jfrverdasca/cpu_ram_gauge/(commit log)

2026-10-06 Notes: lighting colours and salvaged LEDs
2026-10-06 Notes: all lighting LEDs on 150 ohm for now
2026-10-06 Notes: bill of materials as tables
2026-10-06 Notes: complete bill of materials
2026-10-06 Add wiring diagram
2026-10-08 Notes: current CPU cost and RTC summer time
2026-10-08 Add the DS3231 clock and mount the driver chip side up on the perfboard
    With no data the needle shows the minutes and the LCD the time and date.
    gauge.py keeps the clock set; summer time follows the EU rule. The parked
    position moves to the RTC's alarm registers to spare the EEPROM.
2026-10-08 Drop stale LCD text from the queue, end a cut line before parking
2026-10-09 Add photos of the prototype to the README
2026-10-09 Wait 60 ms after the last stop before the needle starts again
    A target falling ~5 steps every 50 ms (the CPU dropping after a heavy
    Spotlight search) made the motor stop and restart while the rotor was
    still ringing, losing dozens of steps going down. The wait now counts
    from the last stop instead of a fixed 20 ms delay() on each start, and
    doesn't block serial or the LCD.
    [gauge.ino, gauge.py]
2026-10-09 Track the HOME_PHASE recalibration for the new motor
    The note pointed to to-do 6, which is already done; give the
    recalibration its own to-do. Also say that homing uses the same settle
    wait as any other move.
2026-10-09 Open the serial port exclusively
    macOS and Linux let a second program open the port, and the Arduino then
    gets two streams of readings: during the bench tests a test script and
    gauge.py both wrote, and the needle swung between their values. A second
    gauge.py now fails to lock the port and retries. The lock is advisory, so
    programs that don't ask for it can still open the port.
    [gauge.py]
2026-10-10 Show the app behind the needle on the LCD while it's high
    The LCD only named the app using the most of the metric the needle
    wasn't showing, so with the needle high there was no way to tell what
    was driving it. Row 1 now swaps uptime and network for that app and its
    own share once the needle's metric passes 60%, back below 50%. The share
    is capped at the total: summed RSS counts shared pages once per process,
    and the app scan is up to 5 s old.
    [gauge.py]
2026-10-10 Scan the top apps every second while CPU or RAM is high
    Row 1 switched to the app as soon as the needle's metric crossed its
    threshold, but with the name from the last scan, up to 5 s old: loading
    every core showed VS Code first. A new process also reads 0% CPU on its
    first scan, so it took up to ~10 s to show. Scan at once when a metric
    crosses its threshold and every second while it stays high; the
    resends of brightness, clock and glyphs stay at 5 s.
2026-10-10 Keep the CPU app on row 0 while its figures are stale
    Clearing top_cpu after waking or a CPU rise also cleared the name on
    row 0 (the CPU row with the needle on RAM), which showed "C 63%" alone
    for a second. The stale scan now keeps the last CPU app and only hides
    it on row 1. hot() no longer keeps state: main() holds whether each
    metric is high and passes lcd_rows() which app rows to show.
    [gauge.py]
2026-10-13 Calibrate the scale so 50% points the needle straight up
    Add homing ('h'), go to percent ('gN') and mark 50% ('m') to step_counter,
    with the same zero as gauge.ino, and set POS_MAX to the measured 230.
2026-10-13 Make the Arduino only the physical part and add the Pomodoro
    gauge.py now decides what the needle and the LCD show (protocol 2: "N" needle,
    "T<row>" text, "CLICK" from the button) and holds the modes; the Arduino keeps
    the motor, scale, homing, parking, clock, lamp test and the new Pomodoro, so
    those work without the computer. Settings sent only on connect and on READY.
    Main button acts on release: click, 1 s Pomodoro, 3 s lamp test (1 s at 100%);
    the release after a forced homing is ignored. Pomodoro button on D11, piezo on
    D13 with tone and volume (duty cycle) from gauge.py.
    Tests run on the computer: gauge.py against a fake serial port, gauge.ino
    against a simulated Arduino (tests/run.s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
2026-10-13 Let gauge.py rest while the Arduino runs the Pomodoro
    Only a slow needle (every 250 ms) goes, so the Arduino doesn't park when the
    Pomodoro ends; no app scans, network or LCD text. Also notes keeping the
    Pomodoro across a reset (to do).
2026-10-13 End the Pomodoro on reconnect and clamp the cycle to fewer cycles
    connect() reads the READY itself, so after a USB drop the script kept
    thinking the Pomodoro ran and stopped sending the LCD rows. An M with
    fewer cycles mid-Pomodoro could also show "Focus 4/2".
2026-10-14 Keep HOME_PHASE at 6: the scale was measured after this motor's homing
2026-10-14 Move what the gauge shows into plugins, add email, use one button
    gauge.py keeps the serial port, the loop, sleep, Pomodoro and clicks; what
    the needle and the LCD show comes from plugins in pc/plugins/ (system: CPU
    and RAM, status: uptime and network, email), listed in PLUGINS: their order
    is the needles' click order and the LCD priority. Plugins rest while the
    screen sleeps and in the Pomodoro. Glyphs are loaded into the LCD's 8 slots
    only while a row uses them; accents are dropped.
    Email: IMAP every minute in a thread, read-only, account in .env. Each new
    unread message shows until its longest row has scrolled once; after a pause
    the 3 newest, then "+N emails".
    The Pomodoro button (D11)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
2026-10-15 refactor(email): take the poll's result through a Future
    The poll sets a Future from its daemon thread and collect() takes it once
    done(), instead of swapping a shared attribute after is_alive(): the
    race reviews kept pointing at can't happen by construction.
2026-10-16 fix(firmware): follow a creeping target without stopping
    The smoothed CPU moves the target a little every 50 ms; the motor caught
    up, stopped, settled 60 ms and started again, so the needle climbed in
    jerks (35 stops 10% -> 90% in the simulator). Now it waits up to 400 ms
    caught up before stopping, the target slides to each reading over 50 ms,
    and the dead zone applies to readings, so it moves a step at a time. The
    LCD and clock update while caught up. tests/hardware/needle_cycles.py
    checks on the gauge that no steps are lost.
2026-10-16 fix(firmware): settle after an abrupt stop, count the settle from the last step
    Reaching the target above the ramp's foot (a reading pulling it back
    mid-climb) now waits SETTLE_MS before going on, as the rotor rings. Before
    reversing, the settle counts from the last step, so a needle that waited
    at the target reverses at once. Tests for both, and for a reversal right
    after reaching the target.
2026-10-16 refactor(firmware): name the lamp test's states, one button, shared press kinds
    Sweep and Press enums instead of numbers, the Button struct gone with the
    second button, pressKind() for both the release and what the LCD shows,
    no uncalibrated HOME_PHASE case, and weekday() for the three places that
    work it out.
2026-10-16 refactor(firmware): refuse an uncalibrated HOME_PHASE at compile time
    A HOME_PHASE outside 0-7 would leave homing looping for good; step_counter
    keeps -1, for measuring a new motor's phase.
2026-10-16 test(pc): deterministic ease tests, allow SWITCH_SECONDS = 0
